spacelab-ufsc/load-emulator-hardware/(commit log)

2024-11-14 Inicial Schematics
    [Load-emulator.kicad_pcb, Load-emulator.kicad_sch]
2024-11-14 Named the connections of PC-104 according to the loads we're trying to emulate
    [Load-emulator.kicad_sch]
2024-11-26 Finalização dos rótulos do PC104 e leve reorganização espacial do arquivo
    [Load-emulator.kicad_sch]
2025-01-06 Havia um erro onde toda vez que o projeto era aberto, automaticamente dois arquivos eram deletados por recomendação do Kicad. Esse commit não é para ter nenenhuma mudança nos arquivos de importância,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
2025-01-06 Adicionados todos os canais desejados no módulo do current sink, em novas folhas hierárquicas. Falta agora juntar todas as instâncias de folhas duplicadas.
    [Load-emulator.kicad_sch, LowPassFilter.kicad_sch, currentSink1A.kicad_sch, current_sink_subcircuit_sch.kicad_sch, preliminarCircuit.kicad_sch]
2025-01-13 Replacement of the microcontroller w/ picoblade
    [Load-emulator.kicad_pcb, Load-emulator.kicad_sch, LowPassFilter.kicad_sch, currentSink1A.kicad_sch, current_sink_subcircuit_sch.kicad_sch, preliminarCircuit.kicad_sch]
2025-01-17 Picolock added to the schematic
    [Load-emulator.kicad_pcb, preliminarCircuit.kicad_sch]
